tobias-/sagecom-presser/tests/scad_cases_candidate.tsv

# candidate defaults to same cases/params as baseline for normal regression runs.
# label | scad_file | part_to_render | defs(semicolon-separated -D entries)
frame_base | sagemcom_button_pusher_rig.scad | - | rig_part_to_render="frame_only"
solenoid_cradle | sagemcom_button_pusher_rig.scad | - | rig_part_to_render="cradle_only"
combined_printable | sagemcom_button_pusher_rig.scad | - | rig_part_to_render="combined_printable";meter_ref_show=false;meter_centerlines_show=false;solenoid_ref_show=false
