tobias-/sagecom-presser/(commit log)

2026-04-19 Add baseline Sagemcom frame OpenSCAD model
    [sagemcom_meter_clamp.scad]
2026-04-20 print #2
    [sagemcom_button_pusher_rig.scad, sagemcom_meter_clamp.scad, solenoid_only.scad]
2026-04-20 before refactoring
    [sagemcom_button_pusher_rig.scad, sagemcom_meter_clamp.scad, scad_cases_baseline.tsv, scad_cases_candidate.tsv]
2026-04-20 post refactor
    [sagemcom_button_pusher_rig.scad, sagemcom_meter_clamp.scad, scad_cases_baseline.tsv, scad_cases_candidate.tsv, solenoid_only.scad]
2026-04-20 Print #3
    [sagemcom_button_pusher_rig.scad]
2026-04-20 add esphome baseline config for esp32-cam and solenoid control
2026-04-21 add camera holder and fix display visibility in frame
    [sagemcom_button_pusher_rig.scad]
2026-04-22 document esp32-cam board and lens position measurements
